sjgray/HRE-Clone/_Pics/HRGE_Top_Overview-01.jpg

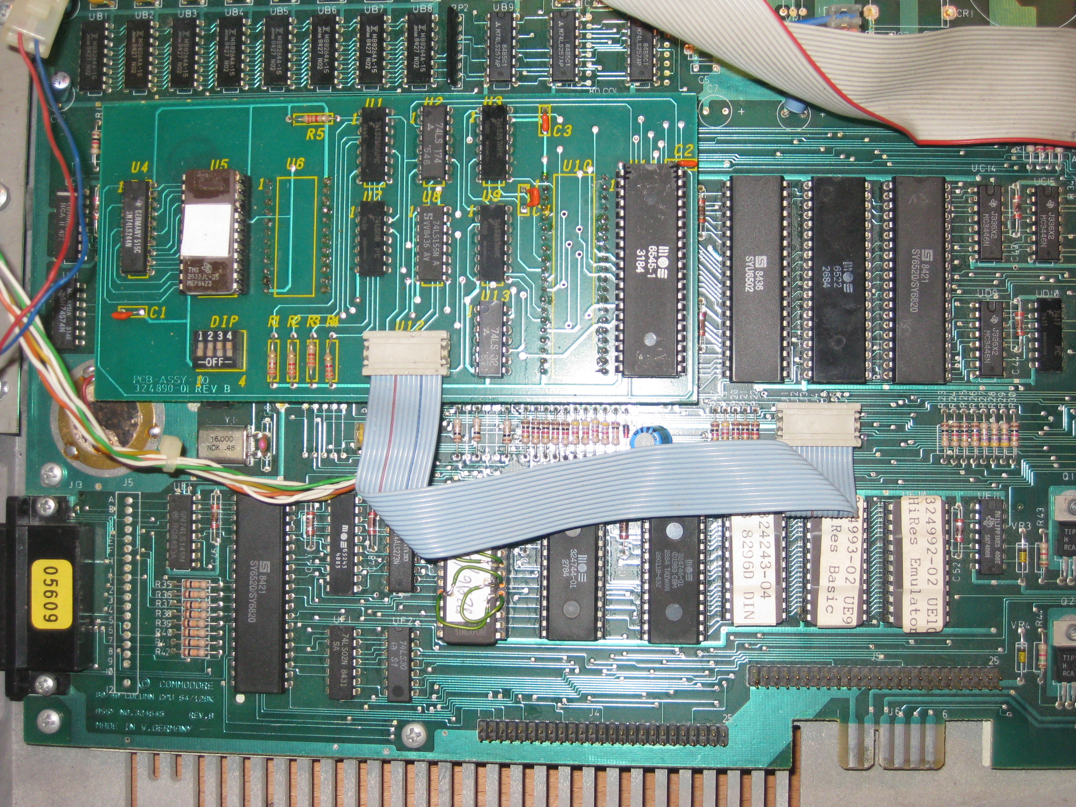
_Pics/HRGE_Top_Overview-01.jpg
