sjgray/HRE-Clone/PCB/Clone/readme.txt

8296 High-Res Emulator (HRE) board clone
========================================

This is a clone of the Commodore 8296 High-Res Emulator (HRE) board.
The HRE is a board plus firmware that emulates the Commodore
High-Speed Graphik (HSG) board which contains a Thomson EF Video Display
Processor (VDP). The HRE firmware implements the same BASIC commands as
the HSG but does the drawing with the 6502 processor rather than the VDP chip.

This is a work-in-progress. It is being cloned using Kicad and some pictures
of the board. This has not been tested! Use at own risk!
