sjgray/HRE-Clone/_Pics/canonical.jpg

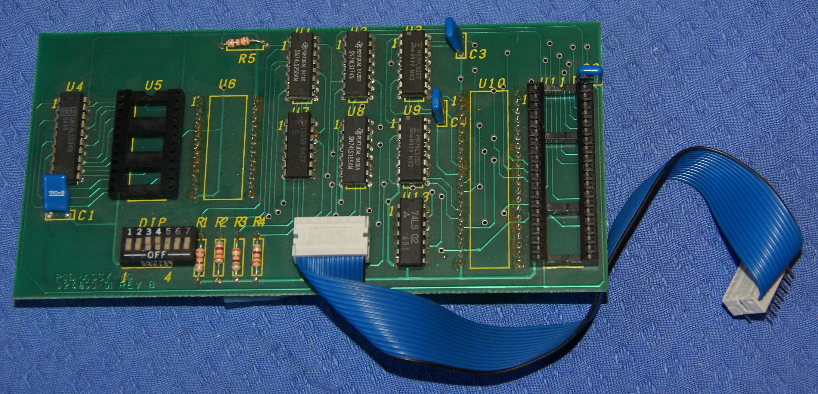
_Pics/canonical.jpg
