sjgray/HRE-Clone/_Pics/HRE-clone-Render-2026-10-10.jpg

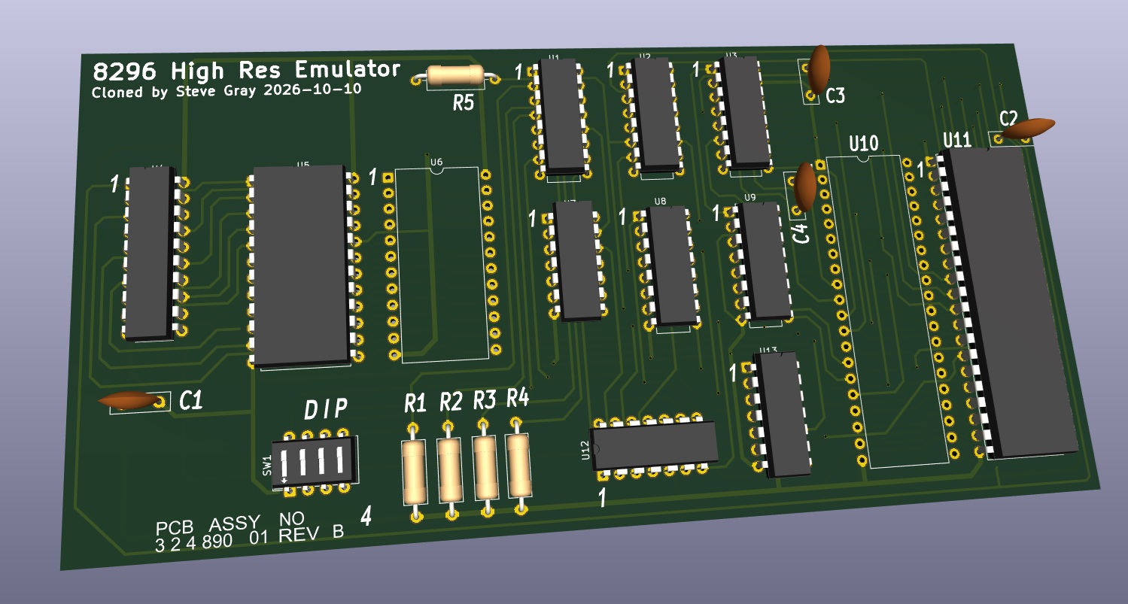
_Pics/HRE-clone-Render-2026-10-10.jpg
