sjgray/HRE-Clone/_Pics/HRE-clone-Routing-2026-10-12.jpg

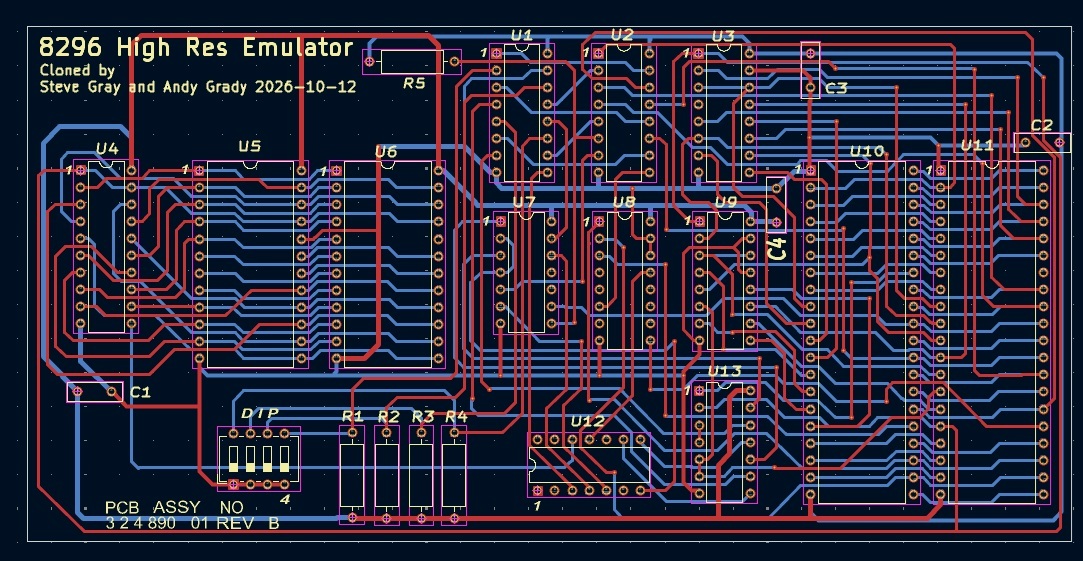
_Pics/HRE-clone-Routing-2026-10-12.jpg
