sjgray/HRE-Clone/_Pics/HRE-clone-vs-mini.jpg

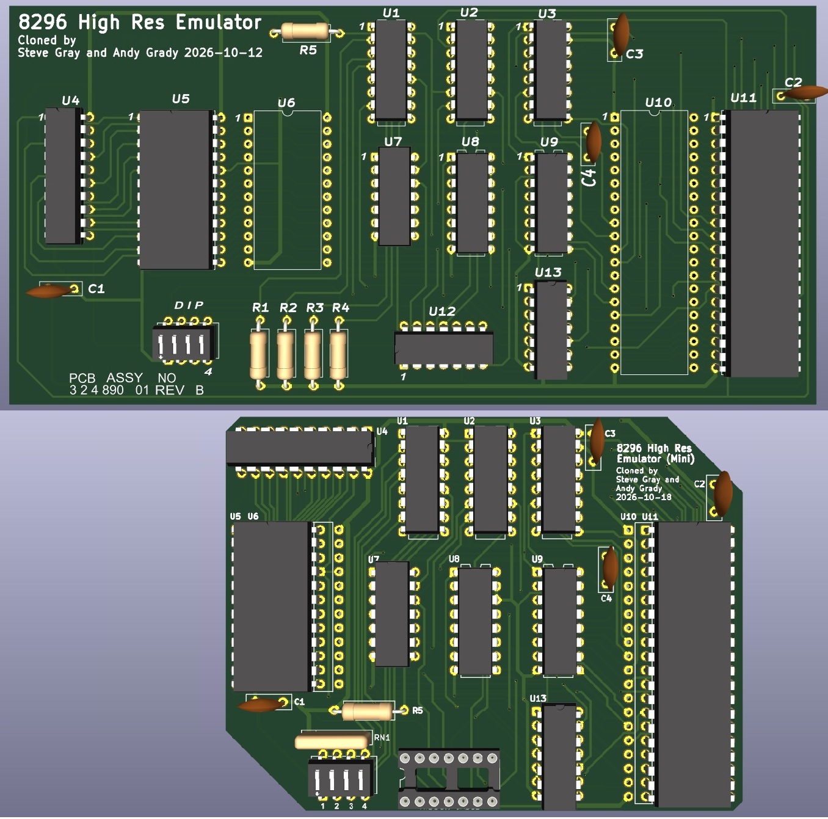
_Pics/HRE-clone-vs-mini.jpg
