sjgray/HRE-Clone/_Pics/HRE-Mini-Render-2026-10-18.jpg

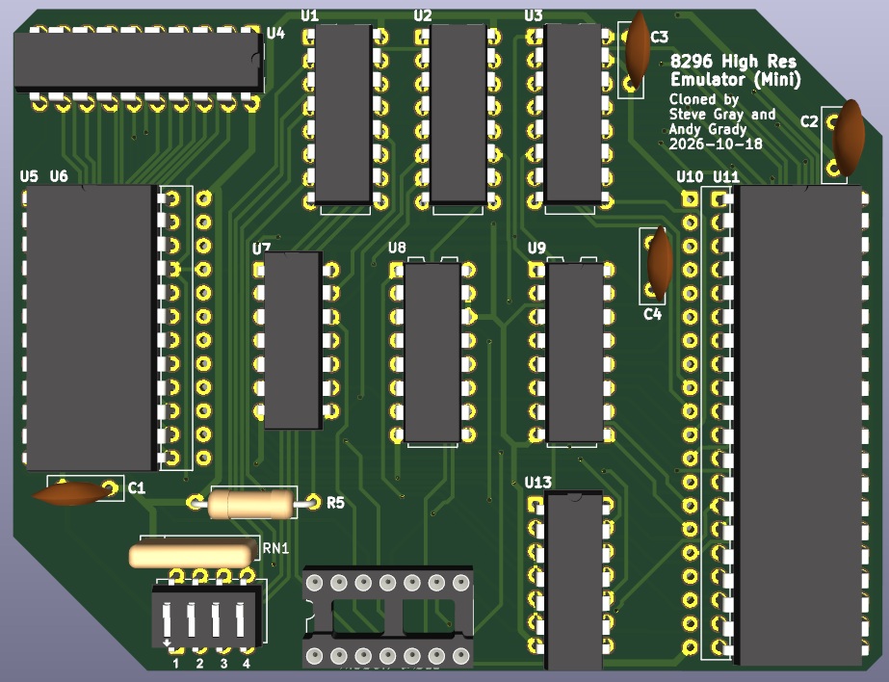
_Pics/HRE-Mini-Render-2026-10-18.jpg
