sjgray/HRE-Clone/_Pics/HRE-Mini-Routing-2026-10-18.jpg

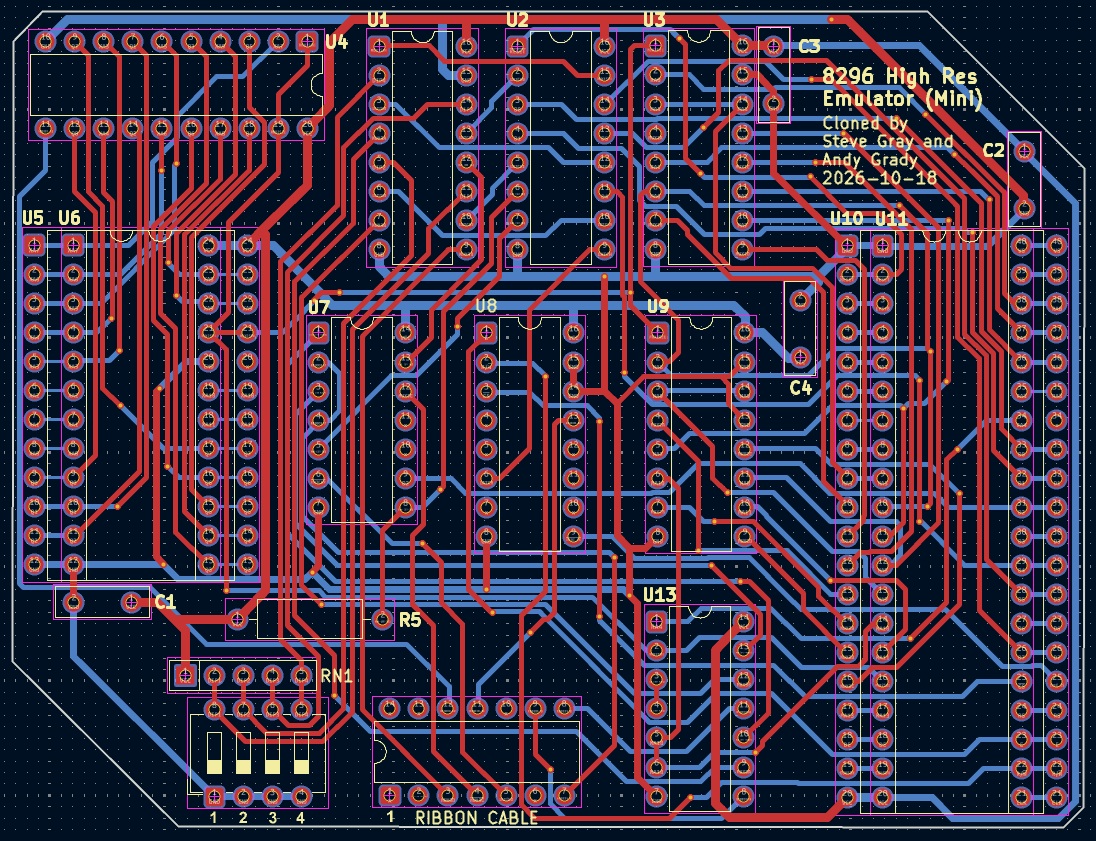
_Pics/HRE-Mini-Routing-2026-10-18.jpg
