sjgray/HRE-Clone/_Pics/under crtc.jpg

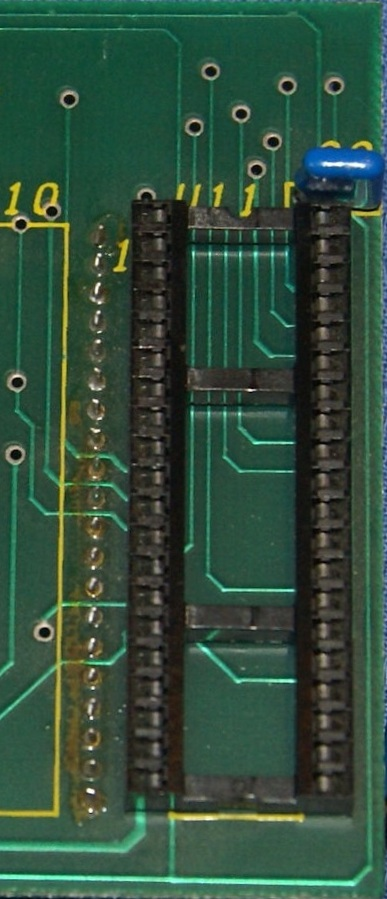
_Pics/under crtc.jpg
