sjgray/HRE-Clone/PCB/Mini/Pics/HRE-Mini-Routing-2026-10-13.jpg

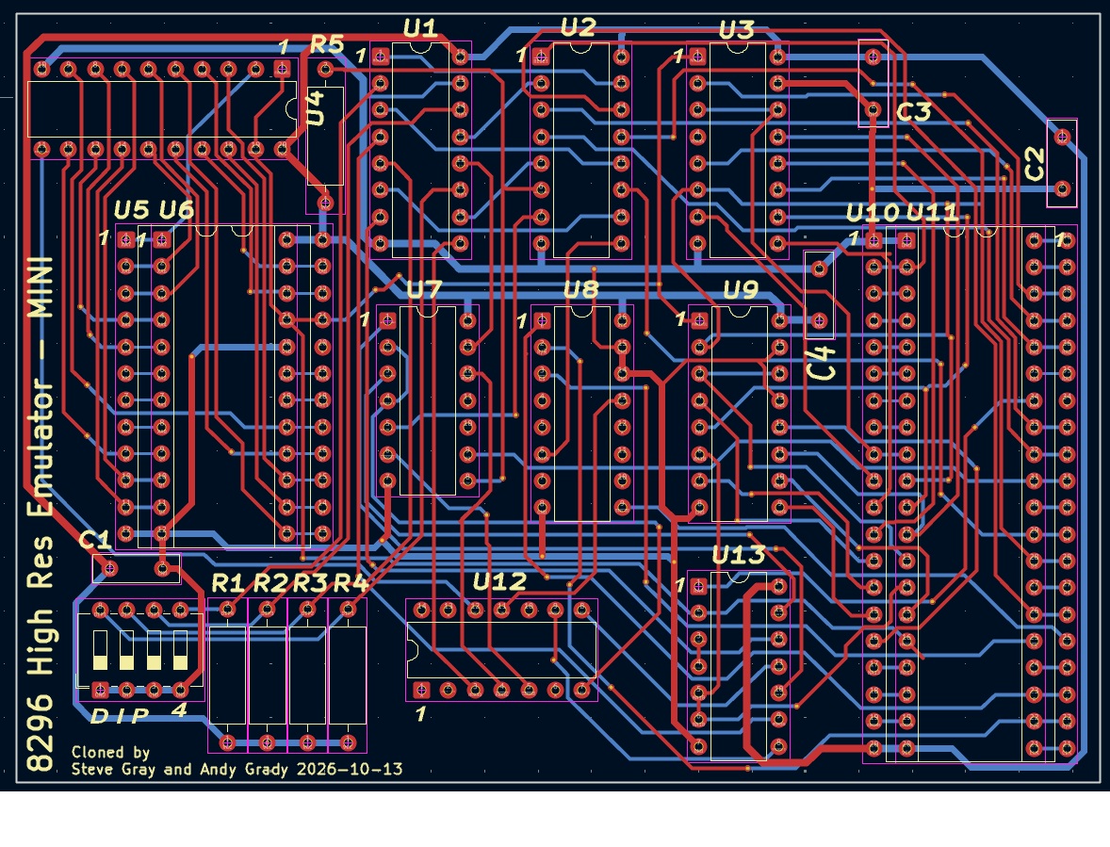
PCB/Mini/Pics/HRE-Mini-Routing-2026-10-13.jpg
