sjgray/HRE-Clone/PCB/Clone/hre-clone.pdf

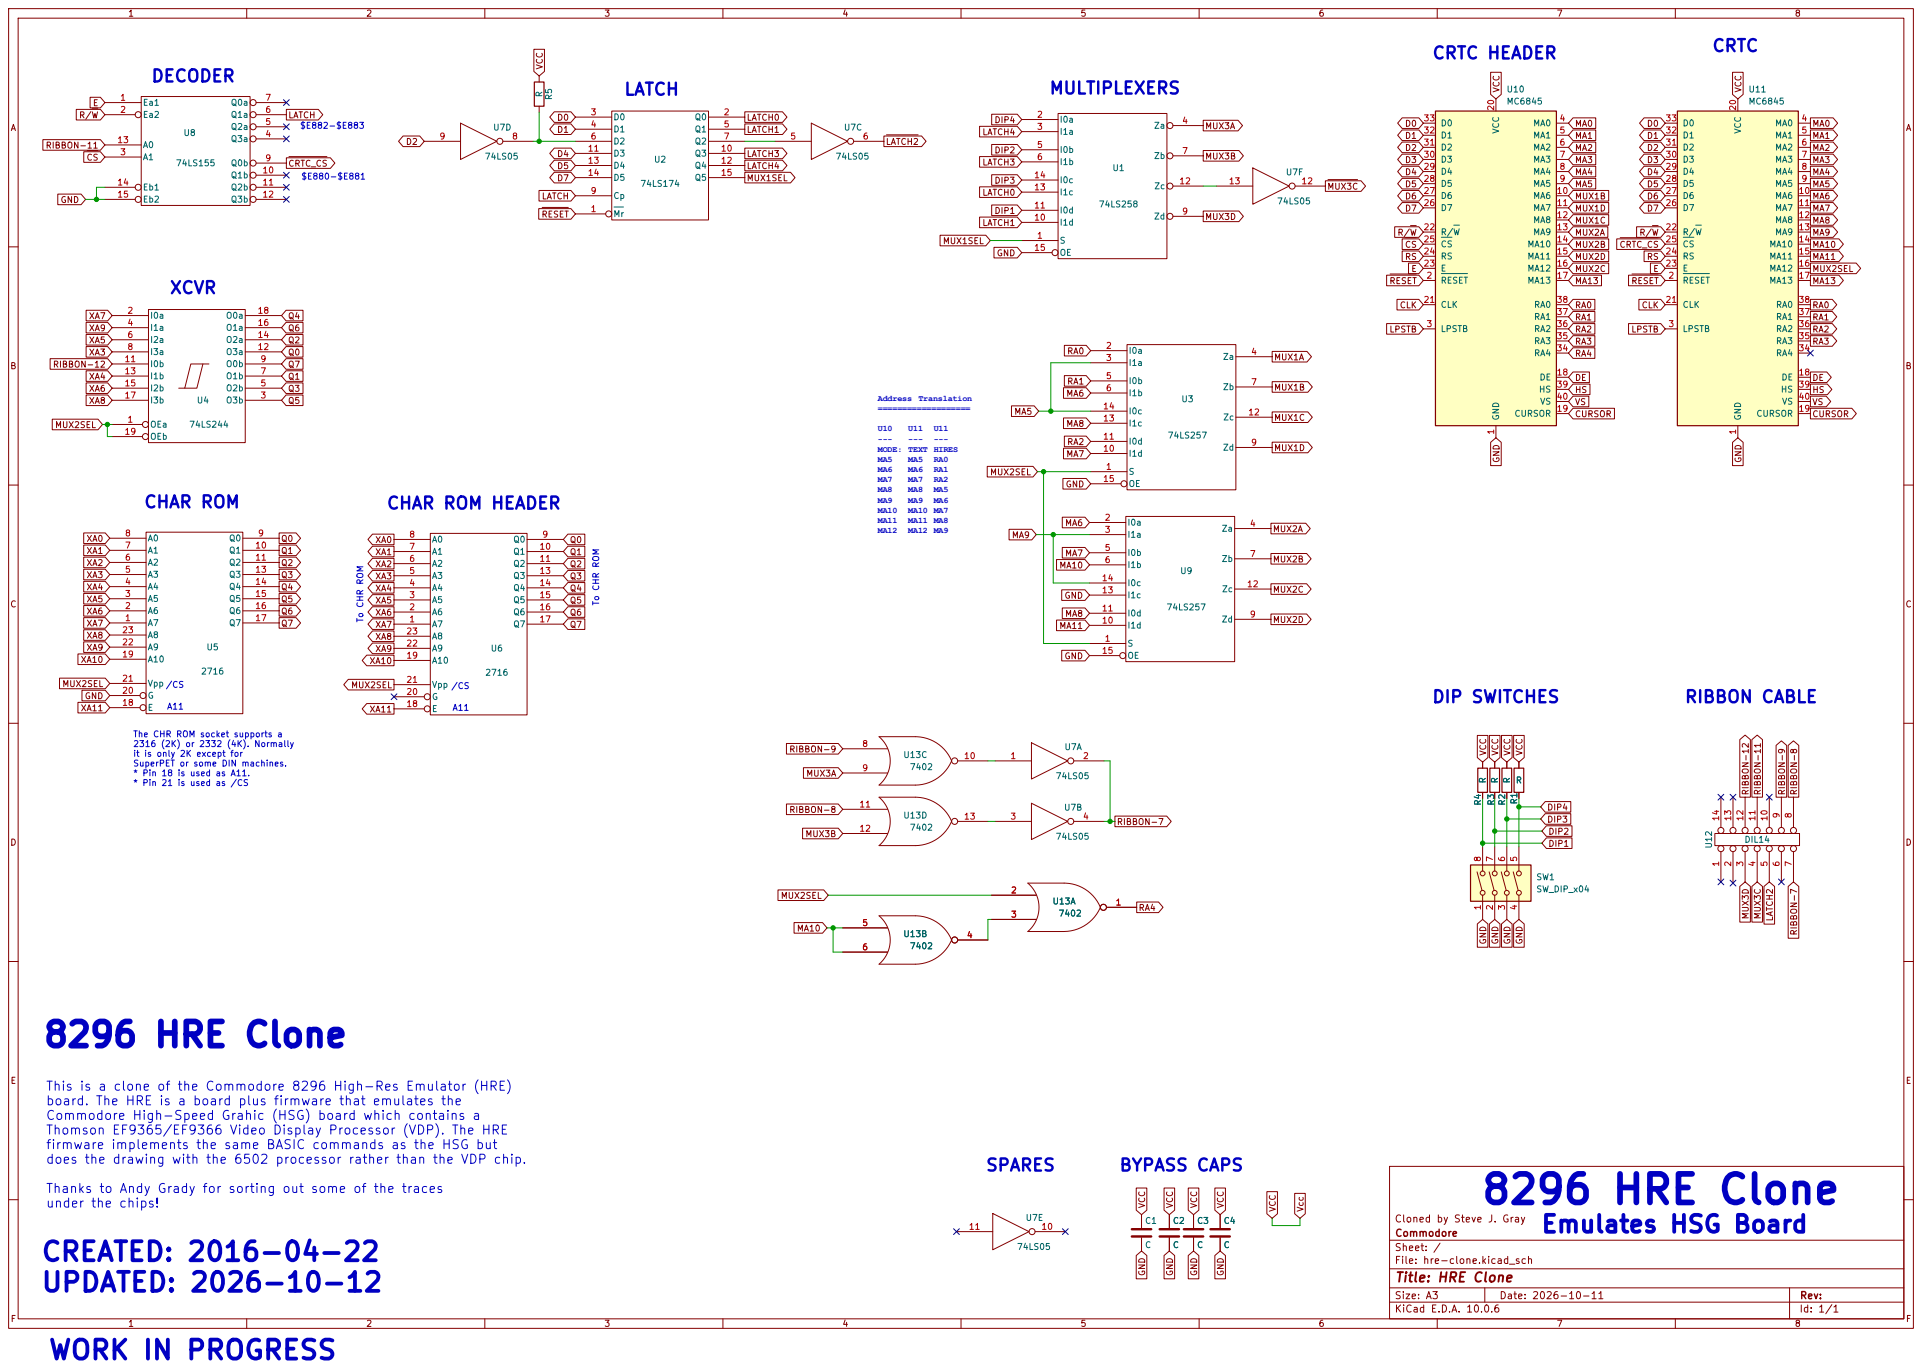
[picture p13: page 1]

The CHR ROM socket supports a 2316 (2K) or 2332 (4K). Normally

it is only 2K except for SuperPET or some DIN machines. * Pin 18 is used as A11. * Pin 21 is used as /CS

This is a clone of the Commodore 8296 High-Res Emulator (HRE)
board. The HRE is a board plus firmware that emulates the
Commodore High-Speed Grahic (HSG) board which contains a
Thomson EF9365/EF9366 Video Display Processor (VDP). The HRE
firmware implements the same BASIC commands as the HSG but
does the drawing with the 6502 processor rather than the VDP chip.

Thanks to Andy Grady for sorting out some of the traces
under the chips!
CREATED: 2016-04-22
UPDATED: 2026-10-12

Cloned by Steve J. Gray
Commodore
Sheet: /
File: hre-clone.kicad_sch
Title: HRE Clone

Size: A3 | Rev: | F Date: 2026-10-11
KiCad E.D.A. 10.0.6 | Id: 1/1
