sjgray/HRE-Clone/PCB/Mini/hre-clone.kicad_pcb

## KiCad design PCB/Mini/hre-clone.kicad_pcb (2026-10-19)

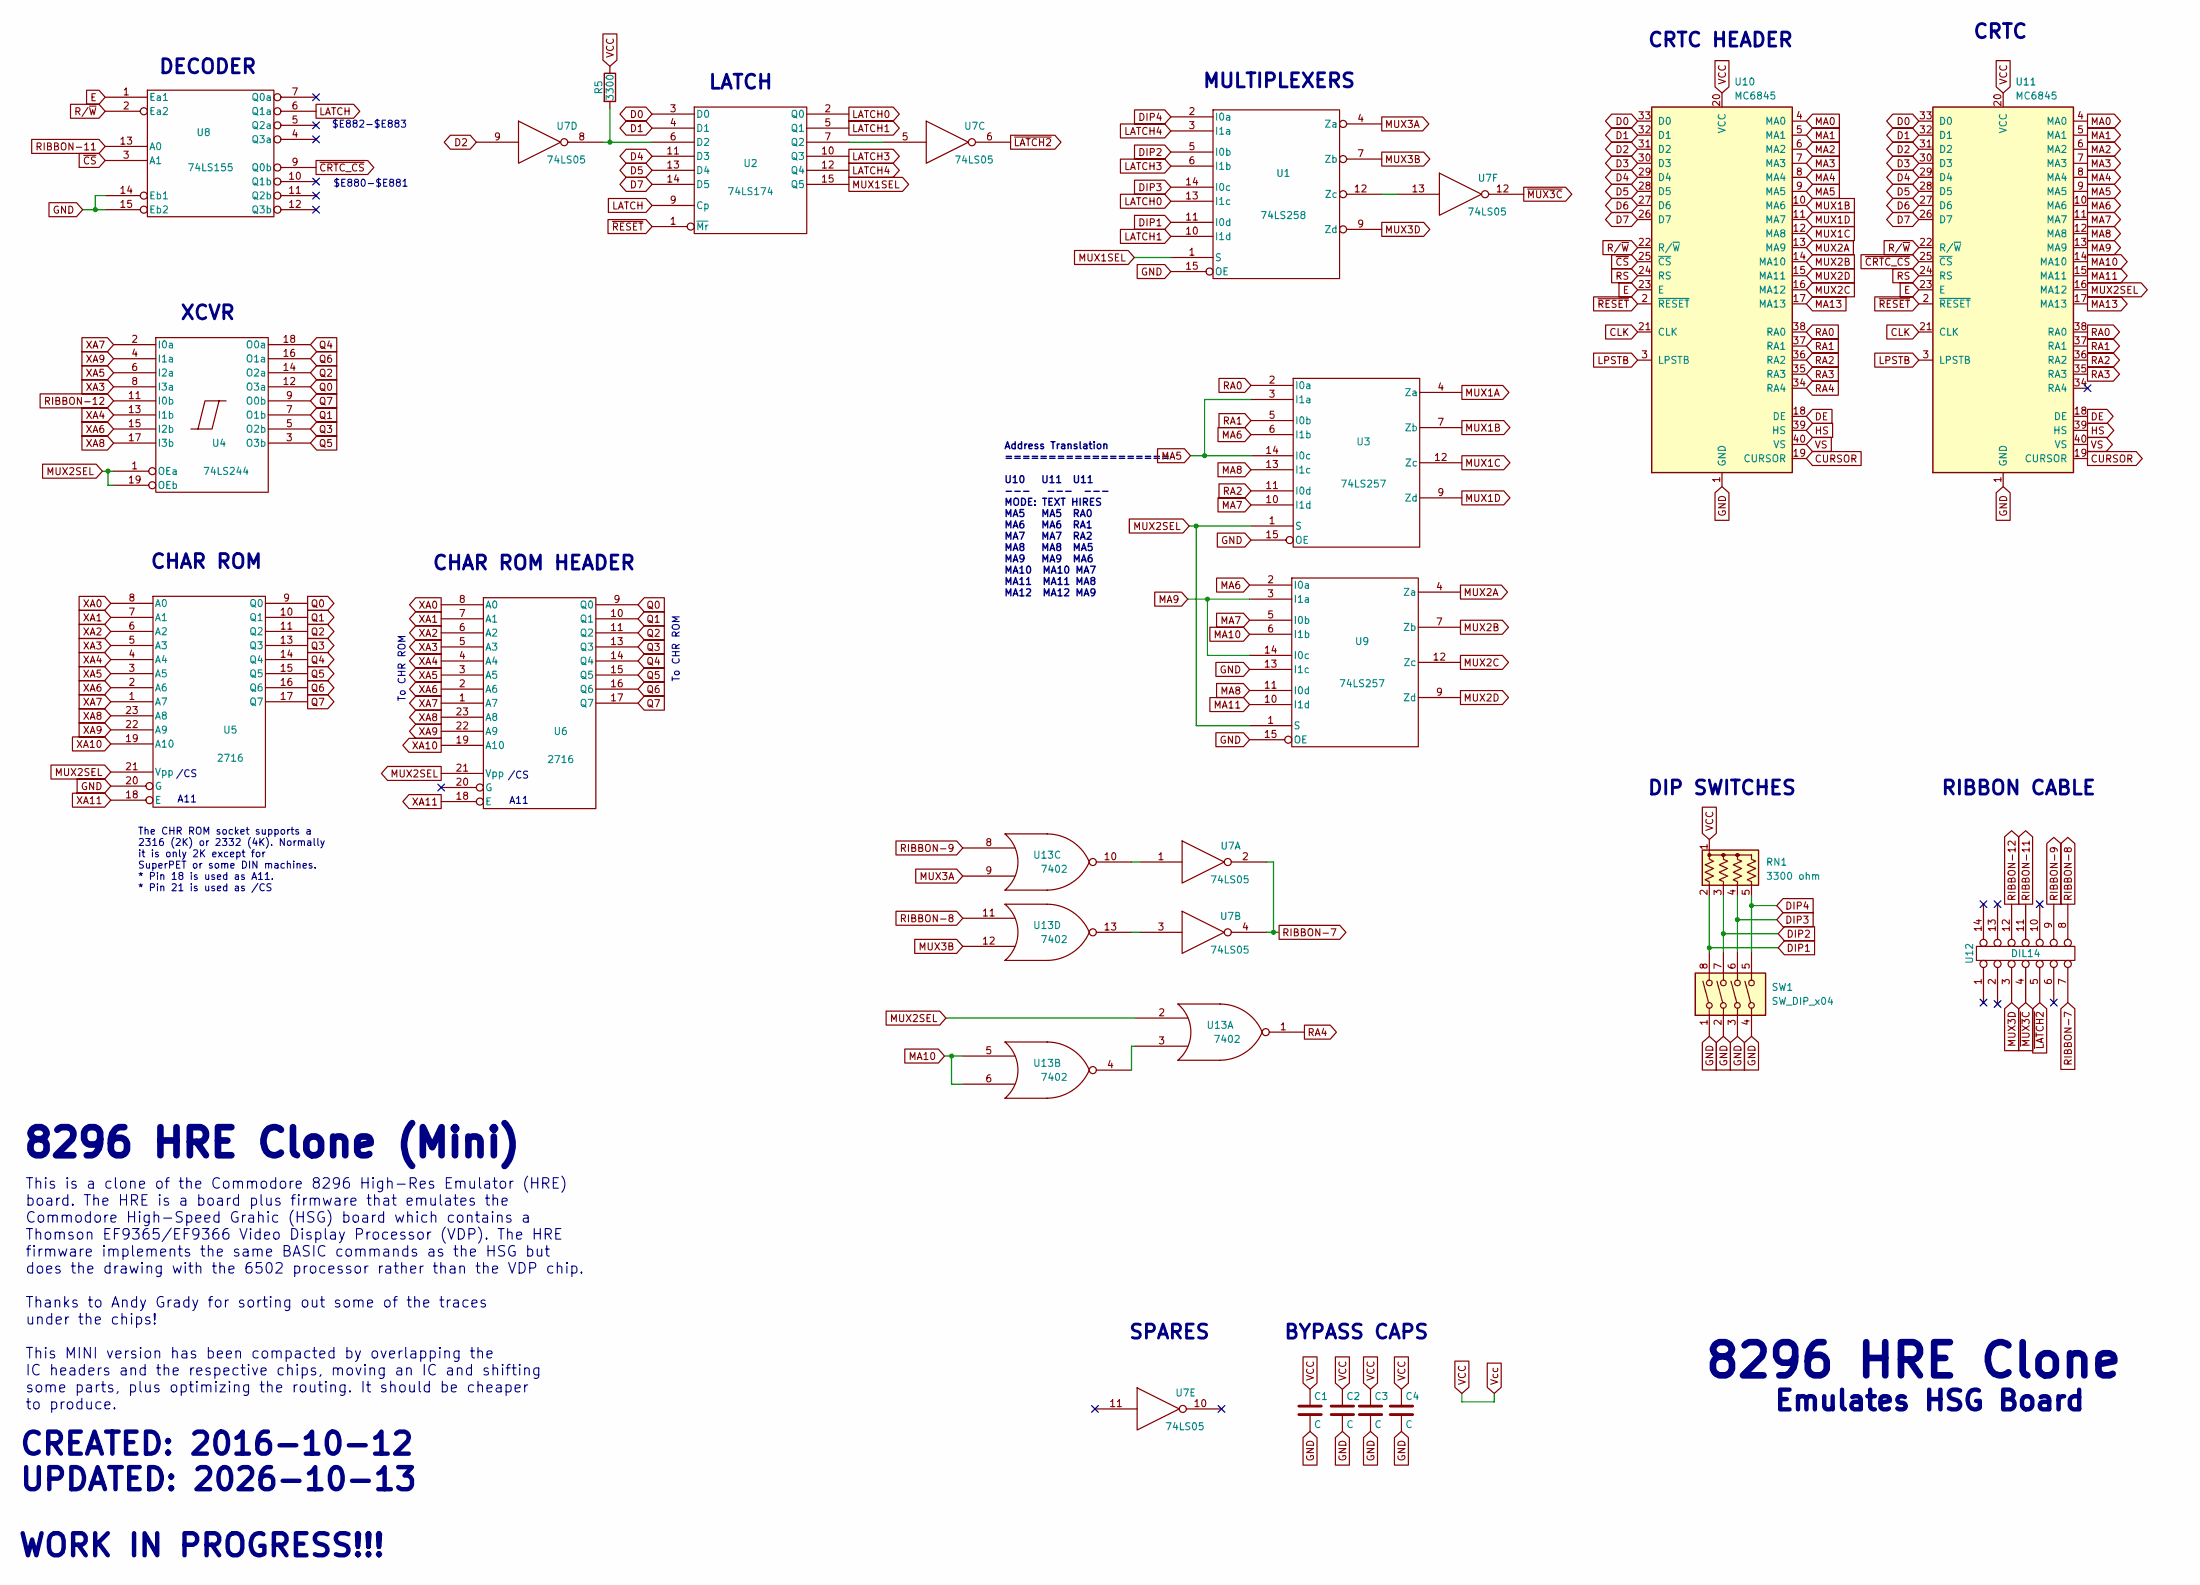
[picture p14: schematic hre-clone.kicad_sch, HRE Clone]

Parts:
C1, C2, C3, C4: C; C_Disc_D8.0mm_W2.5mm_P5.00mm
R5: 3300; R_Axial_DIN0309_L9.0mm_D3.2mm_P12.70mm_Horizontal
RN1: 3300 ohm; R_Array_SIP5
SW1: SW_DIP_x04; SW_DIP_SPSTx04_Slide_6.7x11.72mm_W7.62mm_P2.54mm_LowProfile
U1: 74LS258; DIP-16_W7.62mm
U2: 74LS174; DIP-16_W7.62mm
U3, U9: 74LS257; DIP-16_W7.62mm
U4: 74LS244; DIP-20_W7.62mm
U5, U6: 2716; DIP-24_W15.24mm
U7: 74LS05; DIP-14_W7.62mm
U8: 74LS155; DIP-16_W7.62mm
U10, U11: MC6845; DIP-40_W15.24mm
U12: DIL14; DIP-14_W7.62mm
U13: 7402; DIP-14_W7.62mm

Connections:
CLK: U10.21 (CLK), U11.21 (CLK)
CURSOR: U10.19 (CURSOR), U11.19 (CURSOR)
D0: U2.3 (D0), U10.33 (D0), U11.33 (D0)
D1: U2.4 (D1), U10.32 (D1), U11.32 (D1)
D2: U7.9, U10.31 (D2), U11.31 (D2)
D3: U10.30 (D3), U11.30 (D3)
D4: U2.11 (D3), U10.29 (D4), U11.29 (D4)
D5: U2.13 (D4), U10.28 (D5), U11.28 (D5)
D6: U10.27 (D6), U11.27 (D6)
D7: U2.14 (D5), U10.26 (D7), U11.26 (D7)
DE: U10.18 (DE), U11.18 (DE)
DIP1: RN1.2 (R1), SW1.8, U1.11 (I0d)
DIP2: RN1.3 (R2), SW1.7, U1.5 (I0b)
DIP3: RN1.4 (R3), SW1.6, U1.14 (I0c)
DIP4: RN1.5 (R4), SW1.5, U1.2 (I0a)
E: U8.1 (Ea1), U10.23 (E), U11.23 (E)
GND: C1.2, C2.2, C3.2, C4.2, SW1.1, SW1.2, SW1.3, SW1.4, U1.8 (GND), U1.15 (OE), U2.8 (GND), U3.8 (GND), U3.15 (OE), U4.10 (GND), U5.12 (GND), U5.20 (G), U6.12 (GND), U7.7 (GND), U8.8 (GND), U8.14 (Eb1), U8.15 (Eb2), U9.8 (GND), U9.13 (I1c), U9.15 (OE), U10.1 (GND), U11.1 (GND), U13.7 (GND)
HS: U10.39 (HS), U11.39 (HS)
LATCH: U2.9 (Cp), U8.6 (Q1a)
LATCH0: U1.13 (I1c), U2.2 (Q0)
LATCH1: U1.10 (I1d), U2.5 (Q1)
LATCH3: U1.6 (I1b), U2.10 (Q3)
LATCH4: U1.3 (I1a), U2.12 (Q4)
LPSTB: U10.3 (LPSTB), U11.3 (LPSTB)
MA0: U10.4 (MA0), U11.4 (MA0)
MA1: U10.5 (MA1), U11.5 (MA1)
MA2: U10.6 (MA2), U11.6 (MA2)
MA3: U10.7 (MA3), U11.7 (MA3)
MA4: U10.8 (MA4), U11.8 (MA4)
MA5: U3.3 (I1a), U3.14 (I0c), U10.9 (MA5), U11.9 (MA5)
MA6: U3.6 (I1b), U9.2 (I0a), U11.10 (MA6)
MA7: U3.10 (I1d), U9.5 (I0b), U11.11 (MA7)
MA8: U3.13 (I1c), U9.11 (I0d), U11.12 (MA8)
MA9: U9.3 (I1a), U9.14 (I0c), U11.13 (MA9)
MA10: U9.6 (I1b), U11.14 (MA10), U13.5, U13.6
MA11: U9.10 (I1d), U11.15 (MA11)
MA13: U10.17 (MA13), U11.17 (MA13)
MUX1A: U3.4 (Za)
MUX1B: U3.7 (Zb), U10.10 (MA6)
MUX1C: U3.12 (Zc), U10.12 (MA8)
MUX1D: U3.9 (Zd), U10.11 (MA7)
MUX1SEL: U1.1 (S), U2.15 (Q5)
MUX2A: U9.4 (Za), U10.13 (MA9)
MUX2B: U9.7 (Zb), U10.14 (MA10)
MUX2C: U9.12 (Zc), U10.16 (MA12)
MUX2D: U9.9 (Zd), U10.15 (MA11)
MUX2SEL: U3.1 (S), U4.1 (OEa), U4.19 (OEb), U5.21 (Vpp), U6.21 (Vpp), U9.1 (S), U11.16 (MA12), U13.2
MUX3A: U1.4 (Za), U13.9
MUX3B: U1.7 (Zb), U13.12
MUX3D: U1.9 (Zd), U12.3
unnamed: U1.12 (Zc), U7.13
unnamed: R5.2, U2.6 (D2), U7.8
unnamed: U2.7 (Q2), U7.5
unnamed: U13.3, U13.4
unnamed: U7.1, U13.10
unnamed: U7.3, U13.13
Q0: U4.12 (O3a), U5.9 (Q0), U6.9 (Q0)
Q1: U4.7 (O1b), U5.10 (Q1), U6.10 (Q1)
Q2: U4.14 (O2a), U5.11 (Q2), U6.11 (Q2)
Q3: U4.5 (O2b), U5.13 (Q3), U6.13 (Q3)
Q4: U4.18 (O0a), U5.14 (Q4), U6.14 (Q4)
Q5: U4.3 (O3b), U5.15 (Q5), U6.15 (Q5)
Q6: U4.16 (O1a), U5.16 (Q6), U6.16 (Q6)
Q7: U4.9 (O0b), U5.17 (Q7), U6.17 (Q7)
RA0: U3.2 (I0a), U10.38 (RA0), U11.38 (RA0)
RA1: U3.5 (I0b), U10.37 (RA1), U11.37 (RA1)
RA2: U3.11 (I0d), U10.36 (RA2), U11.36 (RA2)
RA3: U10.35 (RA3), U11.35 (RA3)
RA4: U10.34 (RA4), U13.1
RIBBON-7: U7.2, U7.4, U12.7
RIBBON-8: U12.8, U13.11
RIBBON-9: U12.9, U13.8
RIBBON-11: U8.13 (A0), U12.11
RIBBON-12: U4.11 (I0b), U12.12
RS: U10.24 (RS), U11.24 (RS)
R/~W: U8.2 (Ea2), U10.22 (R/~W), U11.22 (R/~W)
VCC: C1.1, C2.1, C3.1, C4.1, R5.1, RN1.1 (common), U1.16 (VCC), U2.16 (VCC), U3.16 (VCC), U4.20 (VCC), U5.24 (Vcc), U6.24 (Vcc), U7.14 (VCC), U8.16 (VCC), U9.16 (VCC), U10.20 (VCC), U11.20 (VCC), U13.14 (VCC)
VS: U10.40 (VS), U11.40 (VS)
XA0: U5.8 (A0), U6.8 (A0)
XA1: U5.7 (A1), U6.7 (A1)
XA2: U5.6 (A2), U6.6 (A2)
XA3: U4.8 (I3a), U5.5 (A3), U6.5 (A3)
XA4: U4.13 (I1b), U5.4 (A4), U6.4 (A4)
XA5: U4.6 (I2a), U5.3 (A5), U6.3 (A5)
XA6: U4.15 (I2b), U5.2 (A6), U6.2 (A6)
XA7: U4.2 (I0a), U5.1 (A7), U6.1 (A7)
XA8: U4.17 (I3b), U5.23 (A8), U6.23 (A8)
XA9: U4.4 (I1a), U5.22 (A9), U6.22 (A9)
XA10: U5.19 (A10), U6.19 (A10)
XA11: U5.18 (E), U6.18 (E)
~CRTC_CS: U8.9 (Q0b), U11.25 (~CS)
~CS: U8.3 (A1), U10.25 (~CS)
~LATCH2: U7.6, U12.5
~MUX3C: U7.12, U12.4
~RESET: U2.1 (~Mr), U10.2 (~RESET), U11.2 (~RESET)

Notes on the sheet:
LATCH
CHAR ROM
WORK IN PROGRESS!!!
This is a clone of the Commodore 8296 High-Res Emulator (HRE) board. The HRE is a board plus firmware that emulates the Commodore High-Speed Grahic (HSG) board which contains a Thomson EF9365/EF9366 Video Display Processor (VDP). The HRE firmware implements the same BASIC commands as the HSG but do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
8296 HRE Clone (Mini)
XCVR
DIP SWITCHES
To CHR ROM
$E880-$E881
CRTC HEADER
Emulates HSG Board
Address Translation =================== U10 U11 U11 --- --- --- MODE: TEXT HIRES MA5 MA5 RA0 MA6 MA6 RA1 MA7 MA7 RA2 MA8 MA8 MA5 MA9 MA9 MA6 MA10 MA10 MA7 MA11 MA11 MA8 MA12 MA12 MA9
MULTIPLEXERS
CRTC
CHAR ROM HEADER
SPARES
A11
The CHR ROM socket supports a 2316 (2K) or 2332 (4K). Normally it is only 2K except for SuperPET or some DIN machines. * Pin 18 is used as A11. * Pin 21 is used as /CS
/CS
8296 HRE Clone
BYPASS CAPS
RIBBON CABLE
CREATED: 2016-10-12 UPDATED: 2026-10-13
$E882-$E883
DECODER

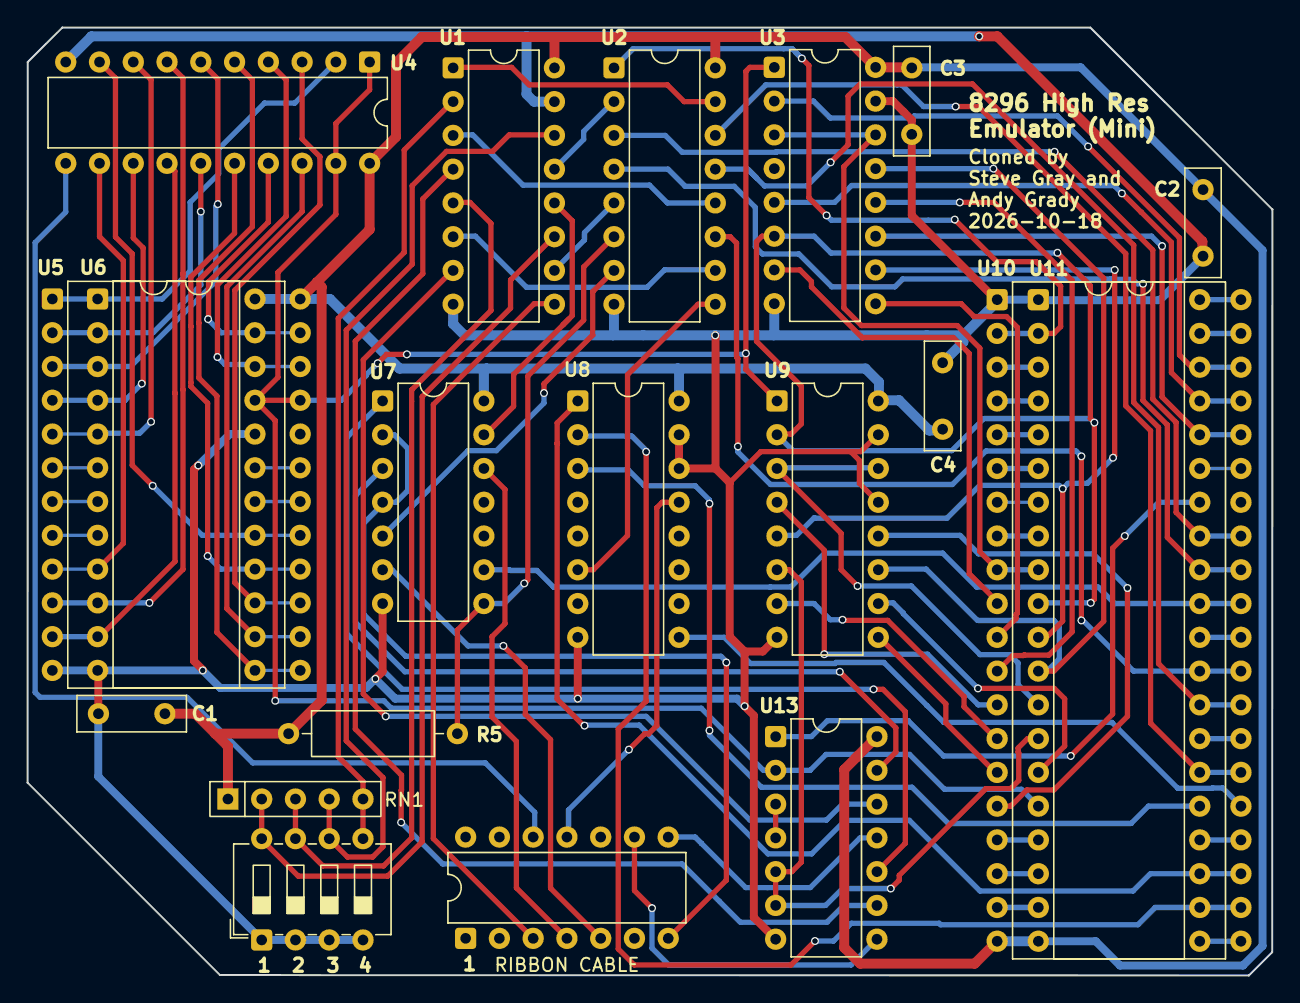
[picture p15: board hre-clone.kicad_pcb from above]

Board: 2 copper layers, 93.6 x 71.3 mm, 20 parts (0 on the bottom side), 94 nets.
