sjgray/HRE-Clone/(commit log)

2026-10-10 Initial Commit
    This is the initial commit. The board is very close to being completely routed but there are traces under the CRTC chip that can't be seen and I do not have a board to study.
    [hre-clone-2019-01-22-12-24-36.sch, hre-clone.kicad_pcb, hre-clone.kicad_sch, hre-clone.sch]
2026-10-10 Re-organize file, remove backup files, update readme
    A little more organization always helps!
    [hre-clone-2019-01-22-12-24-36.sch, hre-clone.kicad_pcb, hre-clone.kicad_sch, hre-clone.sch]
2026-10-10 Some additional PCB fixes
    Getting closer to complete routing. Still some traces under chips that can not be determined.
    [hre-clone.kicad_pcb, hre-clone.kicad_sch]
2026-10-10 Add more pics
    Found a pic of the board with chips removed.
2026-10-12 Updated schematics and routing
    There are now zero unrouted connections, but a few remaining connections missing under the chips. Added a picture of the traces under the CRTC chip.
    [hre-clone.kicad_pcb, hre-clone.kicad_sch]
2026-10-12 Routing complete
    Thanks to Andy Grady for corrections for some traces. DRC check ok. Updated many global labels, moved around some symbols, updated board text etc
    [hre-clone.kicad_pcb, hre-clone.kicad_sch]
2026-10-13 Add Mini version, more pics and PDF schematics.
    Move Clone PCB to subdirectory. Add "Mini" version which is smaller and cheaper to make. Add PDF schematics and additional board renders.
    [hre-clone-2019-01-22-12-24-36.sch, hre-clone.kicad_pcb, hre-clone.kicad_sch, hre-clone.sch]
2026-10-19 Even more Mini!
    Shuffled some chips and traces, added beveled corners and made the text labelling more normal.
    [hre-clone.kicad_pcb, hre-clone.kicad_sch]
